milssky/diploma/Презентация/плата.JPG

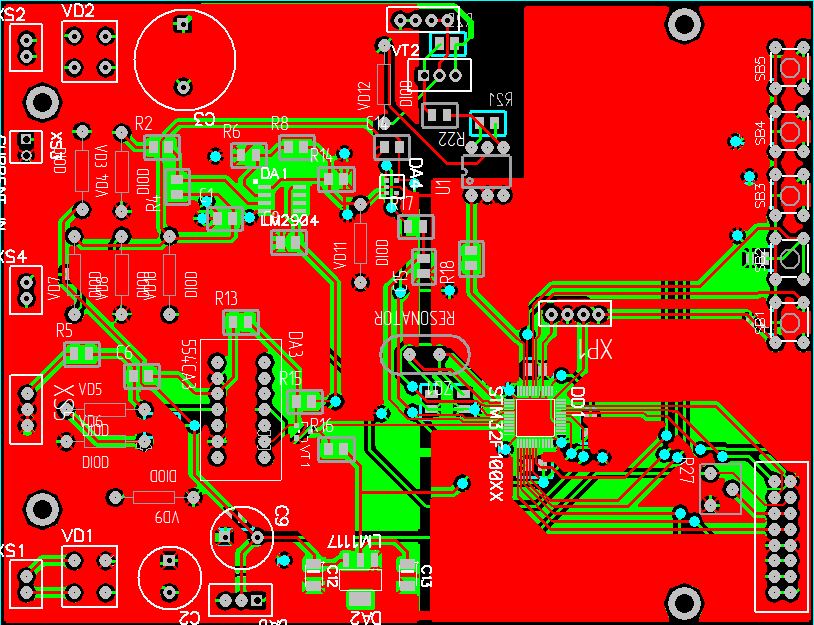
Презентация/плата.JPG
