milssky/diploma/Презентация/фон.jpg

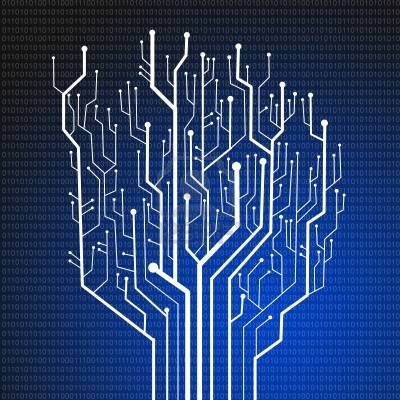
Презентация/фон.jpg
