milssky/diploma/Преддипломная практика/структурная.pdf

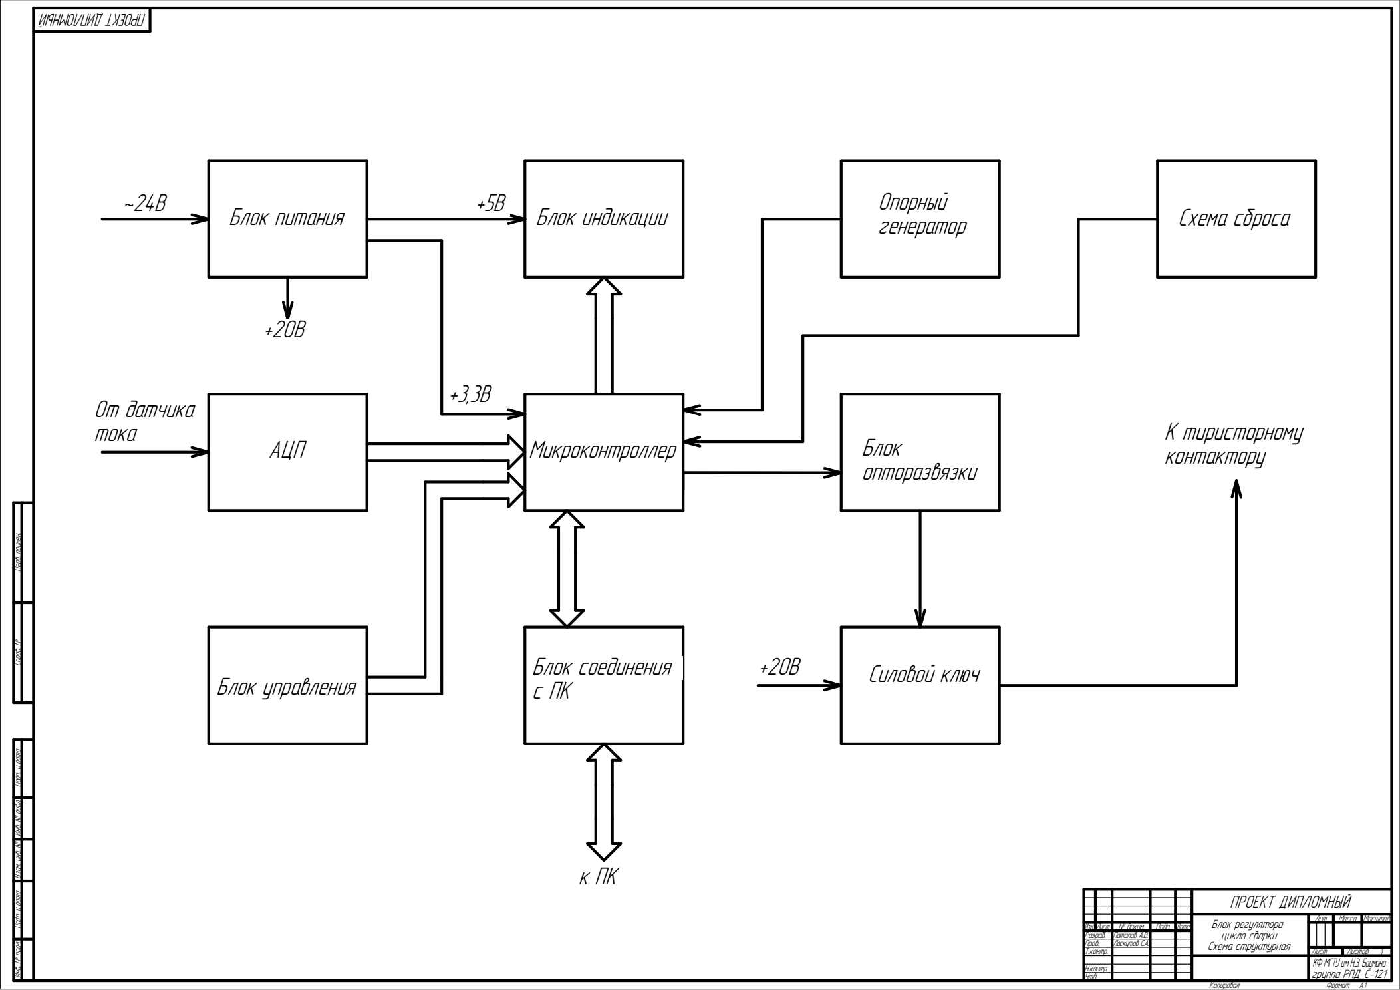
[picture p23: figure]
Ìèêðîêîíòðîëëåð; Áëîê èíäèêàöèè; Áëîê ñîåäèíåíèÿ ñ ÏÊ; ÀÖÏ; Áëîê ïèòàíèÿ; Áëîê óïðàâëåíèÿ; Îïîðíûé ãåíåðàòîð; Áëîê îïòîðàçâÿçêè; Ñèëîâîé êëþ÷; Ñõåìà ñáðîñà; Ê òèðèñòîðíîìó êîíòàêòîðó; +3,3Â Îò äàò÷èêà; òîêà; Èçì.; Ëèñò; ¹ äîêóì.; Ïîäï.; Äàòà; Ðàçðàá.; Ïîòàïîâ À.Â.; Ïðîâ.; Ëîñêóòîâ Ñ.À.; Ò.êîíòð.; Ëèñòîâ 1; Í.êîíòð. Óòâ.; ÏÐÎÅÊÒ ÄÈÏËÎÌÍÛÉ; ÊÔ ÌÃÒÓ èì Í.Ý. Áàóìàíà; Ñïðàâ. ¹ Ïåðâ. ïðèìåí.; Êîïèðîâàë; Ôîðìàò

| | | | | Áëîê ðåãóëÿòîðà öèêëà ñâàðêè Ñõåìà ñòðóêòóðíàÿ | Ëèò. | Ìàññà | Ìàñøòàá

Èíâ. ¹ ïîäë. Ïîäï. è äàòà Âçàì. èíâ. ¹ Èíâ. ¹ äóáë. Ïîäï. è äàòà ãðóïïà ÐÏÄ_Ñ-121
