milssky/diploma/3d/Плата/Сборка блока.png

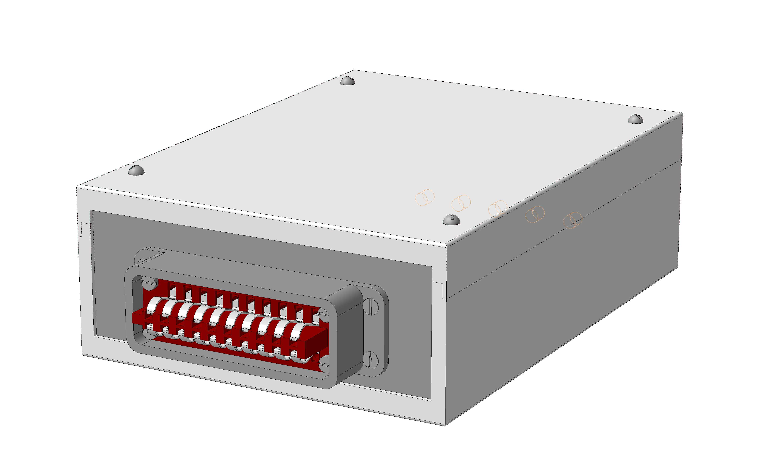
3d/Плата/Сборка блока.png
