milssky/diploma/3d/Сборка блока.jpg

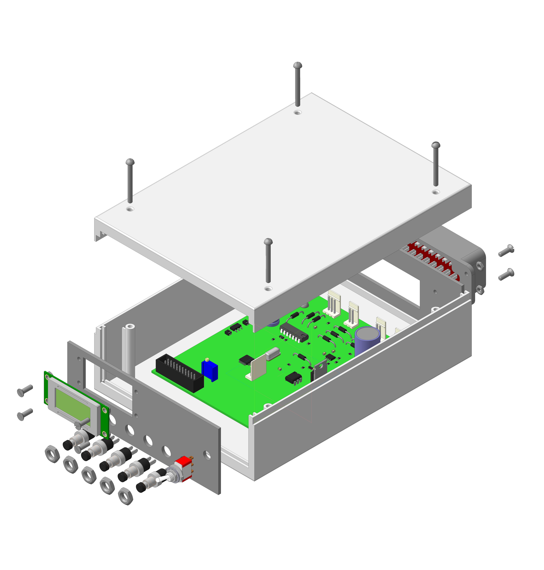
3d/Сборка блока.jpg
