milssky/diploma/3d/Сборка блока.png

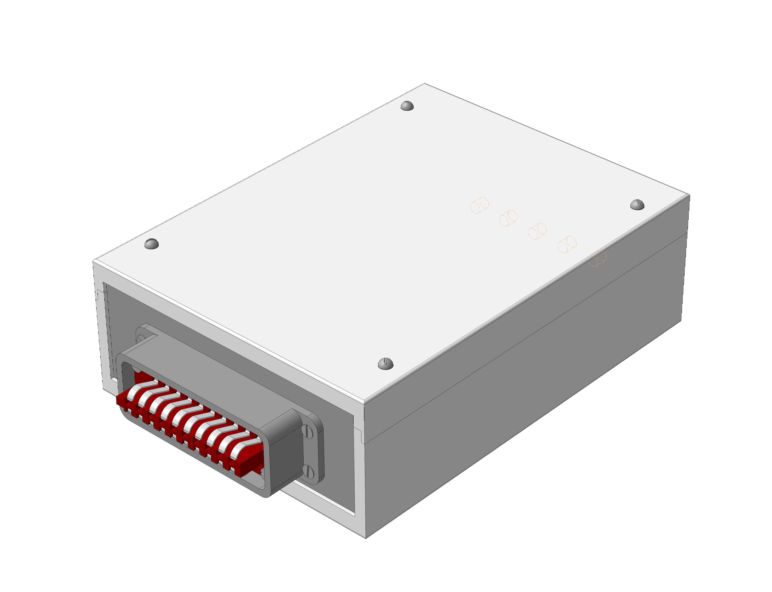
3d/Сборка блока.png
