milssky/diploma/3d/Сборка платы.png

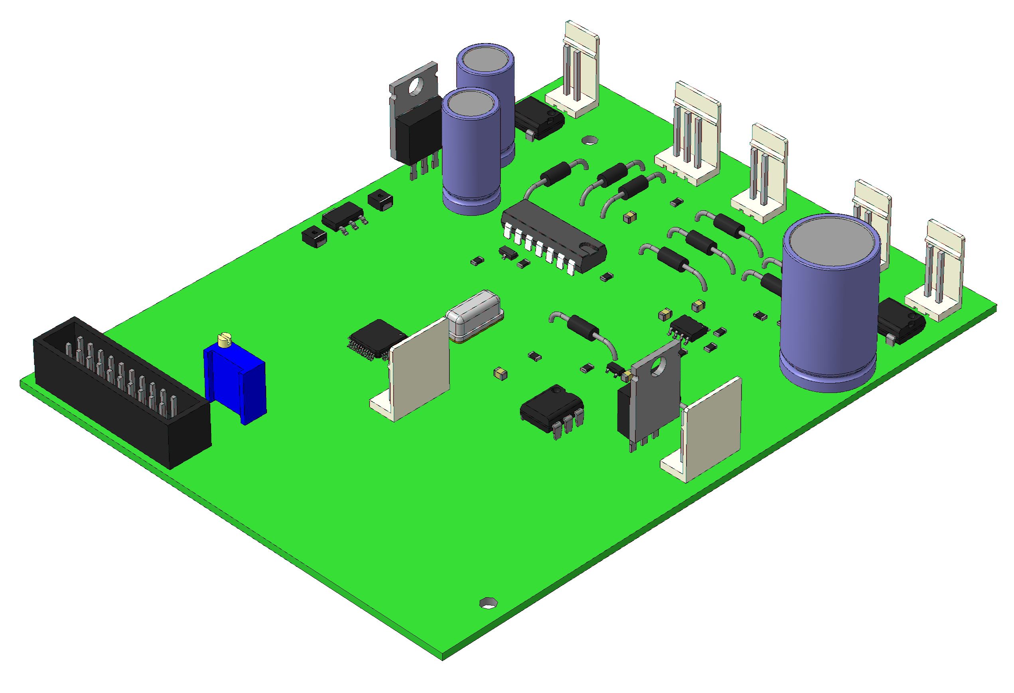
3d/Сборка платы.png
