milssky/diploma/Презентация/bandicam 2013-06-10 00-40-57-685.gif

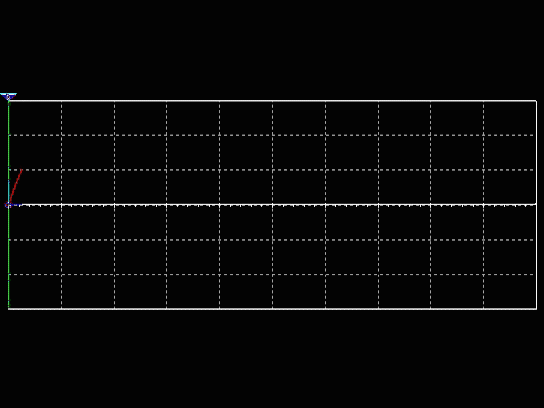
Презентация/bandicam 2013-06-10 00-40-57-685.gif
