milssky/diploma/Презентация/Sequence 01.gif

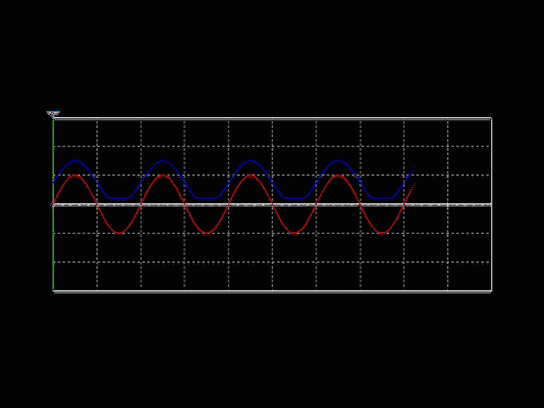
Презентация/Sequence 01.gif
