milssky/diploma/Преддипломная практика/Перечень.xls

Перв. примен. | Поз. обозна- чение |  |  | Наименование |  |  |  |  | Кол. |  | Примечание |  |  | список
 | BQ1 |  |  | Кварцевый резонатор 11.0592 МГц имп. HC-49U |  |  |  |  | 1
 |  |  |  | Чип-конденсаторы GRM216R71 0805 |  |  |  |  |  |  | Murata
 | C1 |  |  | GRM216R71 0805 10 нф, ± 1 % |  |  |  |  | 1
Справ. № | C2,C3 |  |  | GRM216R71 0805 0,1 мк ± 1 % |  |  |  |  | 2
 | C4 |  |  | GRM216R71 0805 22 ± 1 % |  |  |  |  | 1
 | C5 |  |  | GRM216R71 0805 0,1 мк ± 1 % |  |  |  |  | 1
 | C6 |  |  | GRM216R71 0805 22 ± 1 % |  |  |  |  | 1
 | C7 |  |  | GRM216R71 0805 0,1 мк ± 1 % |  |  |  |  | 1
 | C8..C15 |  |  | GRM216R71 0805 1 мк ± 1 % |  |  |  |  | 8
 |  |  |  | Микросхемы
Подп. и дата | DA1 |  |  | Микросхема ADUC812 |  |  |  |  | 1 |  | Analog
 | DD1 |  |  | К555ЛН1 |  |  |  |  | 1
 | DD2 |  |  | К555ЛА3 |  |  |  |  | 1
 | DD3 |  |  | К555АП6 |  |  |  |  | 1
Инв. № дубл. | DD4..DD6 |  |  | К555ЛН1 |  |  |  |  | 3
 |  |  |  | Чип-резисторы 0.125Вт 0805 |  |  |  |  |  |  | Phillips
Взам. инв. № |  |  |  | Резисторы подстроечные 3266W-1-103
 | R1…R8 |  |  | 0.125Вт 0805 2,4k ± 5 % |  |  |  |  | 8
Подп. и дата
 |  |  |  |  |  |  | ПРОЕКТ ДИПЛОМНЫЙ
 | Изм. | Лист | № докум. |  | Подп. | Дата
Инв. № подл. | Разраб. |  | Потапов А.В. |  |  |  | Блок регулятора цикла сварки | Лит. |  | Лист |  | Листов
 | Пров. |  | Лоскутов С.А. |  |  |  |  |  |  | 1 |  | 3
 |  |  |  |  |  |  |  | КФ МГТУ группа РПД_С-81
 | Н. контр.
 | Утв. |  |  |  |  |  | Перечень элементов
 |  |  |  |  |  |  | Копировал: | Формат А4
 | Поз. обозна- чение |  |  | Наименование |  |  |  |  | Кол. |  | Примечание
 | R9 |  |  | 0.125Вт 0805 10k ± 5 % |  |  |  |  | 1
 | R10…R15 |  |  | 0.125Вт 0805 2,4k ± 5 % |  |  |  |  | 6
 | R16 |  |  | 3266W-1-103 10k |  |  |  |  | 1
 | R17…R24 |  |  | 0.125Вт 0805 2,4k ± 5 % |  |  |  |  | 8
 | R25…R32 |  |  | 0.125Вт 0805 1k ± 5 % |  |  |  |  | 8
 | R33 |  |  | 0.125Вт 0805 5,1k ± 5 % |  |  |  |  | 1
 | R34 |  |  | 0.125Вт 0805 15k ± 5 % |  |  |  |  | 1
 | R35 |  |  | 0.125Вт 0805 5,1k ± 5 % |  |  |  |  | 1
 | R36 |  |  | 0.125Вт 0805 15k ± 5 % |  |  |  |  | 1
 | R37 |  |  | 0.125Вт 0805 5,1k ± 5 % |  |  |  |  | 1
 | R38 |  |  | 0.125Вт 0805 15k ± 5 % |  |  |  |  | 1
 | R39 |  |  | 0.125Вт 0805 5,1k ± 5 % |  |  |  |  | 1
 | R40 |  |  | 0.125Вт 0805 15k ± 5 % |  |  |  |  | 1
 | R41 |  |  | 0.125Вт 0805 5,1k ± 5 % |  |  |  |  | 1
Подп. и дата | R42 |  |  | 0.125Вт 0805 15k ± 5 % |  |  |  |  | 1
 | R43 |  |  | 0.125Вт 0805 5,1k ± 5 % |  |  |  |  | 1
 | R44 |  |  | 0.125Вт 0805 15k ± 5 % |  |  |  |  | 1
 | R45 |  |  | 0.125Вт 0805 5,1k ± 5 % |  |  |  |  | 1
Инв. № дубл. | R46 |  |  | 0.125Вт 0805 15k ± 5 % |  |  |  |  | 1
 | R47 |  |  | 0.125Вт 0805 5,1k ± 5 % |  |  |  |  | 1
 | R48 |  |  | 0.125Вт 0805 15k ± 5 % |  |  |  |  | 1
Взам. инв. №
 | U1…U8 |  |  | Оптопара AOT128 |  |  |  |  | 8
Подп. и дата | VD1..VD8 |  |  | Диод 1N4007 |  |  |  |  | 8
 |  |  |  | Вилки
 | XP1 |  |  | WF-6 |  |  |  |  | 1 |  | Zhenqin
Инв. № подл. | XP2 |  |  | WF-2 |  |  |  |  | 1 |  | Zhenqin
 |  |  |  |  |  |  | ПРОЕКТ ДИПЛОМНЫЙ |  |  |  |  |  | Лист
 |  |  |  |  |  |  |  |  |  |  |  |  | 2
 | Изм. | Лист | № докум. |  | Подп. | Дата
 |  |  |  |  |  |  | Копировал: | Формат А4
 | Поз. обозна- чение |  |  | Наименование |  |  |  |  | Кол. |  | Примечание
 | XP3 |  |  | WF-5 |  |  |  |  | 1 |  | Zhenqin
 | XP4 |  |  | WF-14 |  |  |  |  | 1 |  | Zhenqin
 | XP5 |  |  | BH-16 |  |  |  |  | 1 |  | Zhenqin
 | XP6 |  |  | BH-20 |  |  |  |  | 1 |  | Zhenqin
 | XP7 |  |  | WF-18 |  |  |  |  | 1 |  | Zhenqin
Подп. и дата
Инв. № дубл.
Взам. инв. №
Подп. и дата
Инв. № подл.
 |  |  |  |  |  |  | ПРОЕКТ ДИПЛОМНЫЙ |  |  |  |  |  | Лист
 |  |  |  |  |  |  |  |  |  |  |  |  | 3
 | Изм. | Лист | № докум. |  | Подп. | Дата
 |  |  |  |  |  |  | Копировал: | Формат А4
