milssky/diploma/Преддипломная практика/принципиальная.pdf

# 35 DGND 21 DGND 8

# DAC0 10 DAC1 3

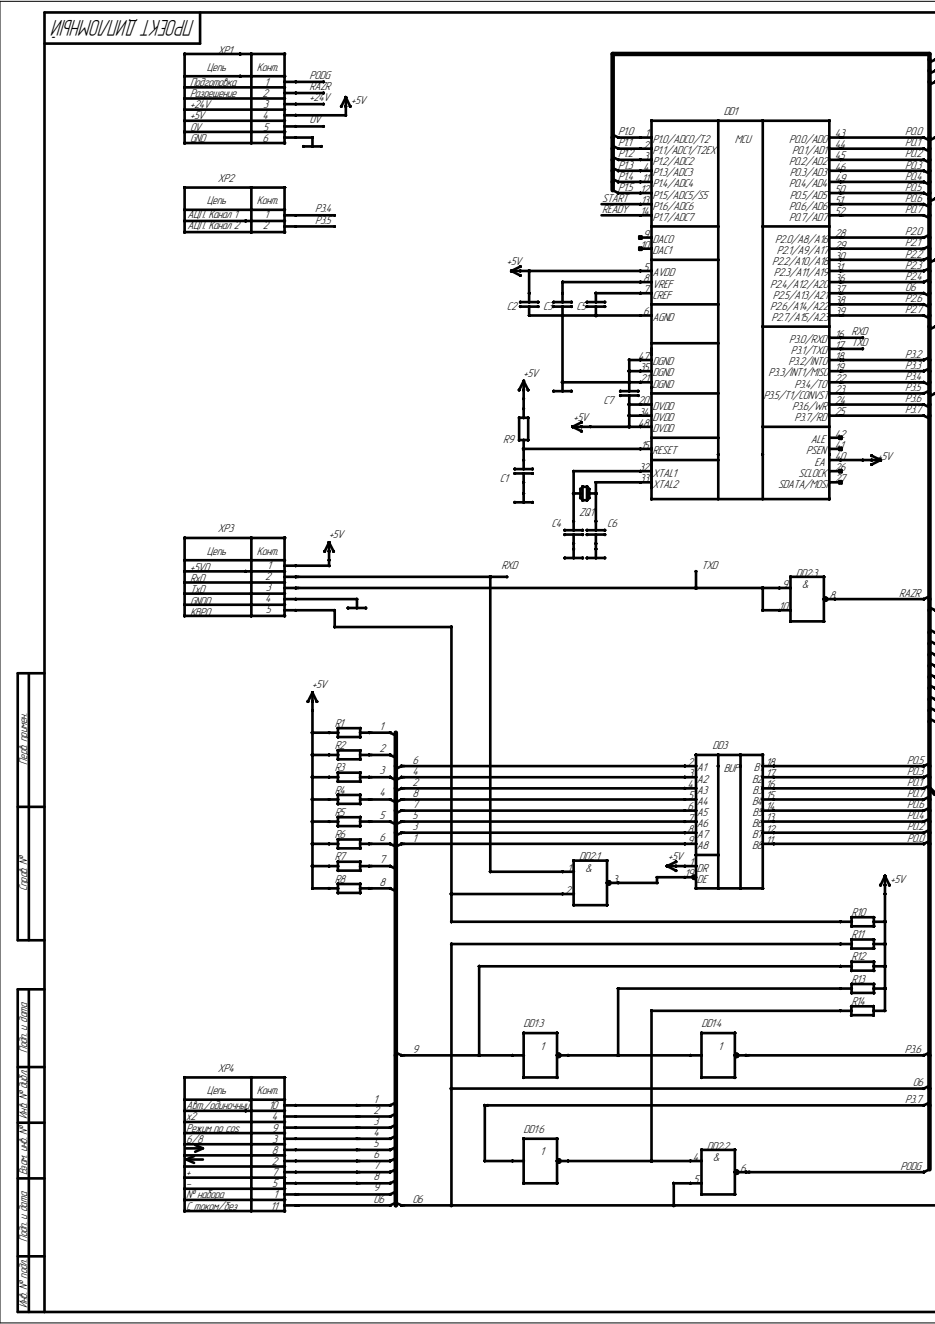
[picture p30: page 1]

Öåïü | Êîíò.
Ïîäãîòîâêà
Ðàçðåøåíèå

ÀÖÏ. Êàíàë 1 ÀÖÏ. Êàíàë 2 | 21

+5VD RxD

TxD
GNDD
KBP0

Èíâ. ¹ ïîäë. Ïîäï. è äàòà Âçàì. èíâ. ¹ Èíâ. ¹ äóáë. Ïîäï. è äàòà Ñïðàâ. ¹ Ïåðâ. ïðèìåí.

Àâò./îäèíî÷íûé õ2

Ðåæèì ïî cos
6/8 -

Ñ òîêîì/áåç +

¹ íàáîðà

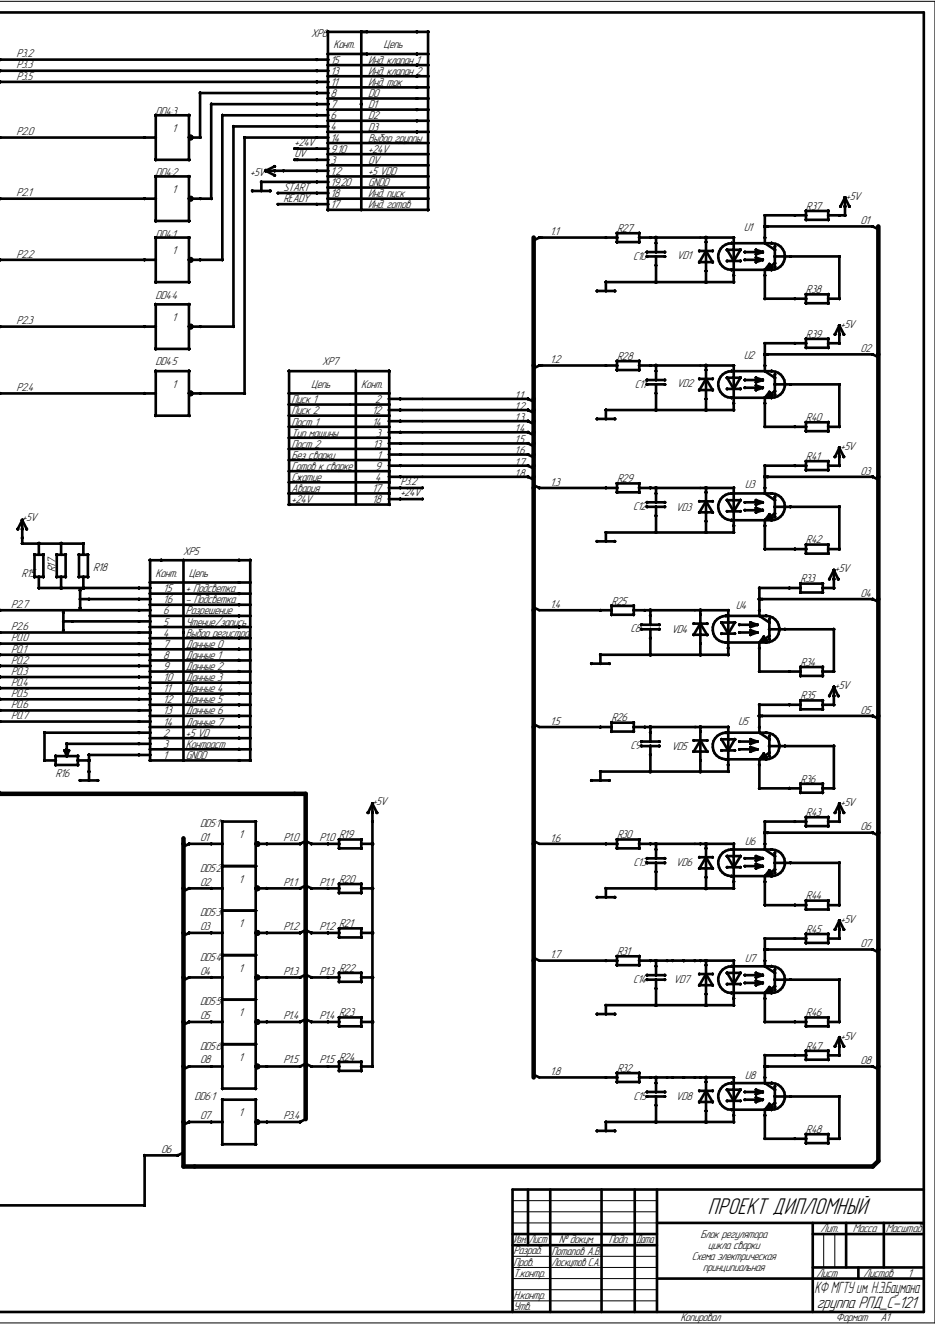
[picture p31: page 2]

Êîíò. | Öåïü
15 | Èíä. êëàïàí 1
13 | Èíä. êëàïàí 2
11 | Èíä. òîê
8 | D0
7 | D1
6 | D2
4 | D3
14 | Âûáîð ãðóïïû
9,10 | +24V
3 | 0V
1,2 | +5 VDD

18 | Èíä. ïóñê
17 | Èíä. ãîòîâ

Öåïü | Êîíò.
Ïóñê 1 Ïóñê 2 | 2

Ïîñò 1 | 14
Òèï ìàøèíû | 3
Ïîñò 2 | 13
Áåç ñâàðêè | 1
Ãîòîâ ê ñâàðêå | 9
Ñæàòèå | 4
Àâàðèÿ | 17
+24V | 18

15 | + Ïîäñâåòêà
16 | - Ïîäñâåòêà
6 | Ðàçðåøåíèå
5 | ×òåíèå/çàïèñü
4 | Âûáîð ðåãèñòðà
7 | Äàííûå 0
8 | Äàííûå 1
9 | Äàííûå 2
10 | Äàííûå 3
11 | Äàííûå 4
12 | Äàííûå 5
13 | Äàííûå 6
14 | Äàííûå 7
2 | +5 VD
3 | Êîíòðàñò
1 | GNDD

ÊÔ ÌÃÒÓ èì. Í.Ý.Áàóìàíà
ãðóïïà ÐÏÄ_C-121
