milssky/diploma/Моделирование/opto_out.CIR

[Main]
FileType=CIR
Version=9.00
Program=Micro-Cap
Screen=1600,900
MCAPVersion=9.0.6.1
Key ID=2 233 293 684
NLCnt=42
TXCnt=5

[shapedef]
Name=Battery
Line=0,0,22,0
Line=22,-3,22,3
Line=26,-7,26,7
Line=26,0,48,0
Current=32,8,16,8

[shapedef]
Name=Pulse_Source
Root="Vsource.root",0,-12,0
Line=20,-4,20,0
Line=20,0,26,0
Line=26,0,26,4

[shapedef]
Name=Resistor
PolyOpen=12 
PolyLine=0,0
PolyLine=0,0
PolyLine=12,0
PolyLine=14,-4
PolyLine=18,4
PolyLine=22,-4
PolyLine=26,4
PolyLine=30,-4
PolyLine=34,4
PolyLine=36,0
PolyLine=48,0
PolyLine=48,0
Current=32,8,16,8

[shapedef]
Name=Diode
Root="Diode.root",0,-8,0

[shapedef]
Name=NPN
Root="Bjt.root",0,-24,0
PolyClosed=3 ,Solid
PolyLine=20,12
PolyLine=24,12
PolyLine=24,8

[shapedef]
Name=Ground
Line=0,0,12,0
Line=12,-8,12,8
Line=18,-4,18,4
Line=24,0,24,0

[shapedef]
Name=Diode.root
Line=0,0,20,0
Line=28,0,48,0
Rectangle=18,-8,20,8,SOLID
PolyClosed=3 ,Solid
PolyLine=20,0
PolyLine=28,-8
PolyLine=28,8
Current=32,16,16,16

[shapedef]
Name=Vsource.root
Line=0,0,12,0
Line=36,0,48,0
Ellipse=12,-12,36,12
Line=7,5,7,9
Root="Plus.root",39,5,0
Current=32,16,16,16

[shapedef]
Name=Plus.root
Line=-2,0,2,0
Line=0,-2,0,2

[shapedef]
Name=Bjt.root
Line=0,0,13,0
Rectangle=13,-12,15,12,SOLID
Current=32,-24,32,-16
Current=32,24,32,16
Current=0,-8,8,-8
PolyOpen=3 
PolyLine=24,-24
PolyLine=24,-12
PolyLine=14,-2
PolyOpen=3 
PolyLine=24,24
PolyLine=24,12
PolyLine=14,2

[shapedef]
Name=Optocoupler_Dar
Rectangle=0,-16,64,80
Rectangle=16,16,16,24
Line=0,-8,12,-8
PolyClosed=3 ,Solid
PolyLine=4,8
PolyLine=20,8
PolyLine=12,16
Line=12,-8,12,8
Line=20,16,4,16
Line=12,16,12,32
Line=12,32,0,32
Line=0,-8,-16,-8
Line=0,32,-16,32
Line=28,-8,80,-8
Line=64,32,80,32
Line=64,72,80,72
Line=64,72,56,72
Line=64,32,56,32
Line=56,32,56,40
Line=56,72,56,64
Line=56,40,48,48
Line=56,64,48,56
PolyClosed=3 ,Solid
PolyLine=54,58
PolyLine=50,62
PolyLine=54,62
Rectangle=46,44,48,60,SOLID
Line=46,52,40,52
Line=40,32,56,32
Line=40,32,34,38
Line=40,52,34,46
PolyClosed=3 ,Solid
PolyLine=39,47
PolyLine=35,51
PolyLine=39,51
Rectangle=32,34,34,50,SOLID
Line=32,42,28,42
Line=28,42,28,-8
PolyClosed=3 ,Solid
PolyLine=24,38
PolyLine=20,42
PolyLine=24,42
PolyOpen=6 
PolyLine=22,40
PolyLine=20,36
PolyLine=18,40
PolyLine=16,36
PolyLine=14,40
PolyLine=12,36

[compdef]
Name=4N33_MC
Definition=Subckt
Shape=Optocoupler_Dar
Mask=4224
memo=Photodarlington Optocoupler Vr=3V Vceo=30V Ic=150mA
Label Offset=19,81,19,15
PinCnt=5
Pin="4",a,-2,-1,-2,-2
Pin="5",a,-2,4,-2,-2
Pin="3",a,10,9,-2,-2
Pin="1",a,10,4,-2,-2
Pin="2",a,10,-1,-2,-2

[compdef]
Name=Resistor
Definition=Resistor
Shape=Resistor
Mask=7681
memo=Resistor
Label Offset=18,6,8,11
PinCnt=2
Pin="Plus",6,0,-10,-4
Pin="Minus",0,0,-14,-4

[compdef]
Name=Ground
Definition=Ground
Shape=Ground
Mask=257
memo=Ground
Label Offset=0,0,0,0
PinCnt=1
Pin="PinA",0,0,-3,-7

[compdef]
Name=Battery
Definition=Battery
Shape=Battery
Mask=4865
memo=Battery
Label Offset=19,7,10,13
PinCnt=2
Pin="Plus",6,0,-4,-5
Pin="Minus",0,0,-10,-5

[compdef]
Name=BCV27_PH
Definition=Subckt
Shape=NPN
Mask=4224
memo=NPN Darlington transistor
Label Offset=29,-14,-6,25
PinCnt=3
Pin="2",a,0,0,-2,-3
Pin="3",a,3,3,6,7
Pin="1",a,3,-3,5,6

[compdef]
Name=Diode
Definition=Diode
Shape=Diode
Mask=4609
memo=Diode
Label Offset=17,10,12,12
PinCnt=2
Pin="Anode",6,0,-9,-8
Pin="Cathode",0,0,-20,-8

[compdef]
Name=Pulse Source
Definition=Pulse source
Shape=Pulse_Source
Mask=4865
memo=Pulse Source
Label Offset=18,13,15,9
PinCnt=2
Pin="Plus",6,0,-5,-4
Pin="Minus",0,0,-19,-4

[Circuit]
Window Placement=2,3, -1,-1, -8,-30, 0,0,1130,522
Default Object=Color=#000080
Default Object Font=Height=-15,FStyle=0,Color=#000080,Name=Arial
Default Object Apply Border To Text=No
Default Object Apply Fill To Text=No
WinBackGround Color=#FFFFFF
Select Color=#FF0000
Select Box Color=#000080
Grid Text Color=Height=-12,FStyle=0,Color=#800000,Name=Arial
Component Color=#0000FF
Attribute Text=Height=-12,FStyle=0,Color=#008000,Name=Arial
Wire Color=#008000
Bus Color=#008000
Pin Connection=Height=-10,FStyle=0,Color=#FF0000,Name=Arial
Node Number=Height=-11,FStyle=0,Color=#FF00FF,Name=Arial
Node Voltage Color=#000000
Dynamic AC Voltage Color=#E4E4E4
Text Banner Text=Height=-15,FStyle=0,Color=#800000,Name=Arial
Title Block Background=#C0C0C0
Current=Height=-11,FStyle=0,Color=#0000FF,Name=Arial
Power/Condition=Height=-11,FStyle=0,Color=#FF0000,Name=Arial
Digital Path Color=#FF0000
Title Block=Height=-15,FStyle=0,Color=#000000,Name=Arial
Disabled	Color=#C0C0C0
KeyWord Color=#0000FF
Error	Color=#FF0000
Digital 0 Color=#000000
Digital R Color=#FFFF00
Digital F Color=#FFFF00
Digital 1 Color=#FF0000
Digital X Color=#C0C0C0
Digital Z Color=#808080
Window Placement in Transient Analysis=2,3, -1,-1, -8,-30, 0,0,1130,522
SpiceType=AMBIGUOUS
Block Select Color=#51F998
TitleBlock Field_1=$name
TitleBlock Field_2=$user $company
TitleBlock Field_3
TitleBlock Field_4=$date
TitleBlock Field_5=Page $page of $maxpage
TitleBlock One Title=False
Title_Block_Border=False
Title_Block=False
Show Nodes=True
Show Voltages=False
Show Current=False
Show Power=False
Show Condition=False
Show Pin Connections=False
Show Cross=False
Show Attribute Text=True
Show Grid Text=True

[Comp]
Name=4N33_MC
Grid=52,37

[Attr]
ONV=19,81,PART,X1
Style=8192

[Attr]
ONV=19,93,NAME,4N33_MC

[Attr]
ONV=19,117,PACKAGE,MOT730A-04

[Comp]
Name=Resistor
Grid=44,36
Rot=6

[Attr]
ONV=-32,6,PART,R1
Style=8192

[Attr]
ONV=-36,18,RESISTANCE,100
Style=8192

[Wire]
Grids=32,36,38,36

[Wire]
Grids=32,36,32,37

[Wire]
Grids=44,36,50,36

[Comp]
Name=Ground
Grid=47,41
Rot=1

[Comp]
Name=Ground
Grid=32,43
Rot=1

[Wire]
Grids=47,41,50,41

[Comp]
Name=Battery
Grid=18,39
Rot=3

[Attr]
ONV=-24,-25,PART,V2
Style=8192

[Attr]
ONV=-22,-37,VALUE,24

[Wire]
Grids=18,39,18,40

[Wire]
Grids=18,30,18,32

[Wire]
Grids=18,40,18,41

[Wire]
Grids=18,32,18,33

[Wire]
Grids=62,41,64,41

[Wire]
Grids=64,41,65,41

[Wire]
Grids=62,36,70,36

[Wire]
Grids=70,36,70,39

[Comp]
Name=Resistor
Grid=70,39
Rot=7

[Attr]
ONV=10,6,PART,R2
Style=8192

[Attr]
ONV=4,22,RESISTANCE,100k
Style=8192

[Wire]
Grids=62,46,70,46

[Wire]
Grids=70,45,70,46

[Wire]
Grids=70,46,72,46

[Comp]
Name=Resistor
Grid=78,46
Rot=6

[Attr]
ONV=-32,6,PART,R3
Style=8192

[Attr]
ONV=-38,18,RESISTANCE,1.5k
Style=8192

[Comp]
Name=Resistor
Grid=83,47
Rot=7

[Attr]
ONV=-32,6,PART,R4
Style=8192

[Attr]
ONV=-36,18,RESISTANCE,10k
Style=8192

[Wire]
Grids=78,46,83,46

[Wire]
Grids=83,46,83,47

[Wire]
Grids=83,53,83,54

[Comp]
Name=BCV27_PH
Grid=87,46

[Attr]
ONV=29,-14,PART,X2
Style=8192

[Attr]
ONV=29,-2,NAME,BCV27_PH

[Attr]
ONV=29,22,PACKAGE,SOT-23

[Wire]
Grids=83,46,87,46

[Wire]
Grids=83,54,87,54

[Wire]
Grids=90,49,90,54

[Wire]
Grids=87,54,87,56

[Wire]
Grids=87,54,90,54

[Comp]
Name=Diode
Grid=90,36
Rot=1

[Attr]
ONV=-31,-22,PART,D1
Style=8192

[Attr]
ONV=-55,-34,MODEL,1N4148

[Attr]
ONV=-51,-58,PACKAGE,DO-35

[Wire]
Grids=90,42,90,43

[Wire]
Grids=90,32,90,35

[Wire]
Grids=90,42,92,42

[Wire]
Grids=90,35,90,36

[Comp]
Name=Pulse Source
Grid=32,43
Rot=3

[Attr]
ONV=-29,-21,PART,V3
Style=8192

[Attr]
ONV=-70,-33,MODEL,SQUARE

[Wire]
Grids=70,46,70,46

[Wire]
Grids=83,46,83,46

[Wire]
Grids=70,46,70,46

[Wire]
Grids=83,46,83,46

[Grid Text]
Text="0v"
Grid=18,40
CBorder=NONE

[Grid Text]
Text="24v"
Grid=18,32
CBorder=NONE

[Grid Text]
Text="24v"
Grid=64,41
CBorder=NONE

[Grid Text]
Text="0v"
Grid=87,56
CBorder=NONE

[Grid Text]
Text="24v"
Grid=90,35
CBorder=NONE

[Schematic]
CurrentSection 0=0
CurrentSection 1=0
CurrentSection 2=0
CurrentSection 3=0
Splitter.xs=0
Splitter.ys=0
TextQuad=4099
Scale=0.5
PrinterScale=1
GridUser=10
ShapeGroups="Main","DeMorgan","Main1","Euro","Rus","Polarity","Main11","Main2","Electrolytic"
CalcRMS=False
CalcAVG=False
CalcPeak=False
DisplayMeasure=Last

[Tools]
Pos=Top
PROBE=Yes
SELECT=Yes
COMP=Yes
TEXT=Yes
WIRE=Yes
WIRED=Yes
BUS=Yes
GRAPHIC=Yes
LINE=No
ELLIPSE=No
RECT=No
DIAM=No
ARC=No
PIE=No
LEFTBRK=No
RIGHTBRK=No
BOTHBRK=No
FLAG=Yes
META=No
INFO=Yes
HELP=Yes
LINK=Yes
REGION_ENABLE=Yes
DIGTRC=No
DIGTRC2=No
DIGALL=No
GRIDTEXT=Yes
COMPTEXT=Yes
NODE=Yes
MEASURED=Yes
NODEV=Yes
CURRENT=Yes
POWER=Yes
CONDITIN=Yes
PIN=Yes
CROSS=Yes
GRID=Yes
BORDER=Yes
TITLE=Yes
RUBBER=Yes
PROPERTY=Yes
STEP=Yes
MIRROR=Yes
ROTATE=Yes
FLIPY=Yes
FLIPX=Yes
FINDCOMP=Yes
FIND=Yes
REPEAT=No
MODEL=Yes
CIR2CKT=No
ATTDISP=No
ENABLE=Yes
DISABLE=Yes
TOFRONT=Yes
TOBACK=Yes
SELNEXT=No
PAGEADD=Yes
PAGEDEL=Yes
ZOOMIN=Yes
ZOOMOUT=Yes
GOTOFLAG=Yes
UPLEVEL=Yes
COLOR=Yes
FONT=Yes

[Section]
Index=0
Name="circuit1"
Type=Main
Enable=True
CurrentPage 0=0
CurrentPage 1=0
CurrentPage 2=0
CurrentPage 3=0
TabSize 0=425
TabSize 1=425
TabSize 2=425
TabSize 3=425

[Page]
Index=0
Section=0
Print=True
Enable=True
Name=Main
Scale 0=1
Scale 1=1
Scale 2=1
SB 3=91,211
Scale 3=0.5
Grid=73,56

[Page]
Index=1
Section=0
Type=Text
Print=False
Enable=True
Name=Text

[Page]
Index=2
Section=0
Type=Text
Print=False
Enable=True
Name=Models
SB 0=0,2

[Page]
Index=3
Section=0
Type=Info
Print=False
Enable=True
Name=Info

[Text Area]
Section=0
Page=1
Font=Height=-15,FStyle=0,Color=#000080,Name=Courier New
Comment Color=#808080
Background Color=#FFFFFF
Len=0


[Text Area]
Section=0
Page=2
Font=Height=-15,FStyle=0,Color=#000080,Name=Courier New
Comment Color=#808080
Background Color=#FFFFFF
Len=239
*** From file C:\MC9\library\UTILITY.LBR
*** 5V Pulse Source
.MODEL PULSE PUL (P1=100u P2=101u P3=102u P4=103u P5=104u)
*** From file C:\MC9\library\UTILITY.LBR
*** 5V Square Wave
.MODEL SQUARE PUL (P1=0 P2=1u P3=500u P4=501u P5=502u)

[Transient]
Window Placement=2,3, -1,-1, -8,-30, 0,0,1130,522
Font=Height=-15,FStyle=0,Color=#0000FF,Name=Arial
WinBackGround Color=#FFFFFF
Select Color=#FF0000
Select Box Color=#000080
Title
AutoTitle=Yes
Grid Color=#808080
Grid Weight=1
Grid Pattern=Dot6
Tracker Foreground=Height=-15,FStyle=0,Color=#000000,Name=Arial
Tracker Background=#FFFF00
Baseline color=#0000FF
Static Grids=False
PlusMark=False
MinorLog25=Off
LabelMinor=Off
OperPoint=True
OperPointOnly=False
AutoScaleRanges=True
DataPoints=False
Token=False
Ruler=False
XAxisGrids=True
YAxisGrids=True
MinorLogGrids=True
BaseLine=False
Graph Background=#FFFFFF
Tracker Intercept=False
Tracker Mouse=True
Tracker Cursor=True
Tracker Cursor BranchInfo=False
Horizontal Cursor=False
Same Y Scales=Yes
Enable X Scaling=True
Enable Y Scaling=True
Keep X Scales The Same=False
Number of Grids X=5
Number of Grids Y=5
Cursor Select Color Primary=#C0C0C0
Cursor Select Color Secondary=#FF0000
Data Point Labels Color Fore=Height=-15,FStyle=0,Color=#000000,Name=Arial
Data Point Labels Color Back=#FFFF00
FFT_NPts="1024"
FFT_IncludeDCHarmonic=False
FFT_AutoScale_Harmonics="10"
PrinterAutoTile=No
PrinterBlackBorder=No
MonMaxShow=3
MonPageWidth=66
MonPlotWidth=21
MonExprXWidth=142
MonExprYWidth=260
MonRangeXWidth=90
MonRangeYWidth=90
AnimateWait=0
AnimateWaitTime=500
Save_For_Future=No
Reduce_Display=1
Reduce_Save=1
Num Out Header Left
Num Out Header Center="$MC\n$user\n$company\n$Analysis of $name"
Num Out Header Right
Num Out Delimiter=32
Num Out Write=True
Num Out Write Main Header=True
Num Out Write Limits=True
Num Out Write Branch Header=True
Num Out Write Models=True
Num Out Write Zero Models=True
Num Out Write Undefined Models=True
Num Out Write Operating Point=True
Num Out Write Values=True
Num Out Write Waveform Header=True
Num Out Low="TMIN"
Num Out High="TMAX"
Num Out Font=Height=-15,FStyle=0,Color=#000080,Name=Courier New

[Tools]
Pos=Top
SELECT=Yes
GRAPHIC=Yes
LINE=No
ELLIPSE=No
RECT=No
DIAM=No
ARC=No
PIE=No
LEFTBRK=No
RIGHTBRK=No
BOTHBRK=No
POLYCLOS=No
SCALE=Yes
CURSOR=Yes
MEASUREH=Yes
MEASUREV=Yes
TAG=Yes
PTAG=Yes
TEXT=Yes
PROPERTY=Yes
START=Yes
STOP=Yes
PAUSE=Yes
DATAPTS=Yes
TOKENS=Yes
RULER=Yes
PLUS=Yes
XAXIS=Yes
YAXIS=Yes
MINORLOG=Yes
LOG25=Yes
BASELINE=Yes
HORIZCUR=Yes
GOTOX=Yes
GOTOY=Yes
GOTOPERF=Yes
GOTOBRNC=Yes
CLEAR_ACCUMULATED=Yes
PDELETE_ALL_PLOTS=Yes
NEXT=Yes
NEXTIN=Yes
PEAK=Yes
VALLEY=Yes
HIGH=Yes
LOW=Yes
INFLECTN=Yes
GHIGH=Yes
GLOW=Yes
BOTTOM=Yes
TOP=Yes
WAVEFORMBUFFER=Yes
AOUTPUT=Yes
PKEY=Yes
ENXSCALE=Yes
ENYSCALE=Yes
ZOOMIN=Yes
ZOOMOUT=Yes
AUTOSCALE=Yes
COLOR=Yes
FONT=Yes
SELNEXT=No

[APage]
Analysis=Transient
Name="Main"

[Monte Carlo Options]
Analysis=Transient
Status=Off
Zero Tolerance=False
Distribution=Normal
Number of Runs=10
Seed=0

[Limits]
Analysis=Transient
TRange=50m
TStep=0.001
NPts=51
Temp=27
RetraceRuns=1
StateVar=Zero
RunOption=Normal
Temperature Type=Linear
Accumulate Plots=False

[WaveForm]
Analysis=Transient
Plt=1
AliasID=1
XExp=T
YExp=v(5)
XRng=0.03
YRng=7.5e6
Options=LINEARX,LINEARY
Range Grid X=0.006
Range Grid Y=1.5e6
Line Color=#0000FF
Text Color=#0000FF
Rainbow=False
VFmtX=3
VFmtY=3
ScaleFactorX="None"
ScaleFactorY="None"
ScaleUnitsX="Auto"
ScaleUnitsY="Auto"
SFmtX=3
SFmtY=3

[WaveForm]
Analysis=Transient
Plt=1
AliasID=2
XExp=T
YExp=v(8)
XRng=0.03
YRng=7.5e6
Options=LINEARX,LINEARY
Range Grid X=0.006
Range Grid Y=1.5e6
Line Color=#FF0000
Text Color=#FF0000
Rainbow=False
VFmtX=3
VFmtY=3
ScaleFactorX="None"
ScaleFactorY="None"
ScaleUnitsX="Auto"
ScaleUnitsY="Auto"
SFmtX=3
SFmtY=3

[WaveForm]
Analysis=Transient
Plt=1
AliasID=3
XExp=T
YExp=v(2)
XRng=0.03
YRng=7.5e6
Options=LINEARX,LINEARY
Range Grid X=0.006
Range Grid Y=1.5e6
Line Color=#008000
Text Color=#008000
Rainbow=False
VFmtX=3
VFmtY=3
ScaleFactorX="None"
ScaleFactorY="None"
ScaleUnitsX="Auto"
ScaleUnitsY="Auto"
SFmtX=3
SFmtY=3

[Limits]
Analysis=DynamicAC
FirstValueDisplay=Mag
SecondValueDisplay=PhaseDeg
PlaceText=True

[Limits]
Analysis=DynamicDC
PlaceText=True

[Pane]
Analysis=Transient
CurrentPage 0="Main"

[Pane]
Analysis=AC

[Pane]
Analysis=DC

[Pane]
Analysis=Distortion

[Watch]
Analysis=Transient
Format=3
ExprPercentWidth=80

[OPMethods]
Analysis=Transient
Standard Newton-Raphson=0,0
Source Stepping=0,0
Diagonal Gmin Stepping=0,0
Junction Gmin Stepping=0,0
Pseudo Transient=0,0

[OPMethods]
Analysis=AC
Standard Newton-Raphson=0,0
Source Stepping=0,0
Diagonal Gmin Stepping=0,0
Junction Gmin Stepping=0,0
Pseudo Transient=0,0

[OPMethods]
Analysis=DC
Standard Newton-Raphson=0,0
Source Stepping=0,0
Diagonal Gmin Stepping=0,0
Junction Gmin Stepping=0,0
Pseudo Transient=0,0
