milssky/diploma/Моделирование/comprator.CIR

[Main]
FileType=CIR
Version=9.00
Program=Micro-Cap
Screen=1600,900
MCAPVersion=9.0.6.1
Key ID=2 233 293 684
NLCnt=64
TXCnt=7

[shapedef]
Name=Battery
Line=0,0,22,0
Line=22,-3,22,3
Line=26,-7,26,7
Line=26,0,48,0
Current=32,8,16,8

[shapedef]
Name=Sine_Source
Root="Vsource.root",0,-12,0
Line=24,-6,26,-4
Line=26,-4,26,-2
Line=26,-2,22,2
Line=22,2,22,4
Line=22,4,24,6

[shapedef]
Name=Resistor
PolyOpen=12 
PolyLine=0,0
PolyLine=0,0
PolyLine=12,0
PolyLine=14,-4
PolyLine=18,4
PolyLine=22,-4
PolyLine=26,4
PolyLine=30,-4
PolyLine=34,4
PolyLine=36,0
PolyLine=48,0
PolyLine=48,0
Current=32,8,16,8

[shapedef]
Name=Capacitor
Line=0,0,22,0
Line=22,-8,22,8
Line=26,-8,26,8
Line=26,0,48,0
Current=32,12,16,12

[shapedef]
Name=Diode
Root="Diode.root",0,-8,0

[shapedef]
Name=NPN
Root="Bjt.root",0,-24,0
PolyClosed=3 ,Solid
PolyLine=20,12
PolyLine=24,12
PolyLine=24,8

[shapedef]
Name=Ground
Line=0,0,12,0
Line=12,-8,12,8
Line=18,-4,18,4
Line=24,0,24,0

[shapedef]
Name=Diode.root
Line=0,0,20,0
Line=28,0,48,0
Rectangle=18,-8,20,8,SOLID
PolyClosed=3 ,Solid
PolyLine=20,0
PolyLine=28,-8
PolyLine=28,8
Current=32,16,16,16

[shapedef]
Name=Opamp.root
Line=0,48,6,48
Line=0,0,5,0
Line=6,-4,6,52
Line=6,-4,48,24
Line=6,52,48,24
Line=48,24,72,24
Line=10,12,14,12
Line=12,10,12,14
Line=10,36,14,36
Line=4,0,6,0

[shapedef]
Name=Minus.root
Line=-2,0,2,0

[shapedef]
Name=Vsource.root
Line=0,0,12,0
Line=36,0,48,0
Ellipse=12,-12,36,12
Line=7,5,7,9
Root="Plus.root",39,5,0
Current=32,16,16,16

[shapedef]
Name=Plus.root
Line=-2,0,2,0
Line=0,-2,0,2

[shapedef]
Name=Bjt.root
Line=0,0,13,0
Rectangle=13,-12,15,12,SOLID
Current=32,-24,32,-16
Current=32,24,32,16
Current=0,-8,8,-8
PolyOpen=3 
PolyLine=24,-24
PolyLine=24,-12
PolyLine=14,-2
PolyOpen=3 
PolyLine=24,24
PolyLine=24,12
PolyLine=14,2

[shapedef]
Name=Comp6
Root="Plus.root",7,-14,0
Root="Minus.root",7,44,0
Line=16,48,16,26
Line=16,-16,16,5
Line=24,21,24,40
Line=24,40,56,40
Root="Opamp.root",-16,-12,0

[compdef]
Name=k544ca3
Definition=Subckt
Shape=Comp6
Mask=4096
Label Offset=0,0,-23,193
PinCnt=6
Pin="1",a,-2,-1
Pin="2",a,-2,5
Pin="3",a,2,-2
Pin="4",a,2,6
Pin="5",a,7,2
Pin="6",a,7,5

[compdef]
Name=Diode
Definition=Diode
Shape=Diode
Mask=4609
memo=Diode
Label Offset=17,10,12,12
PinCnt=2
Pin="Anode",6,0,-9,-8
Pin="Cathode",0,0,-20,-8

[compdef]
Name=Resistor
Definition=Resistor
Shape=Resistor
Mask=7681
memo=Resistor
Label Offset=18,6,8,11
PinCnt=2
Pin="Plus",6,0,-10,-4
Pin="Minus",0,0,-14,-4

[compdef]
Name=Ground
Definition=Ground
Shape=Ground
Mask=257
memo=Ground
Label Offset=0,0,0,0
PinCnt=1
Pin="PinA",0,0,-3,-7

[compdef]
Name=Battery
Definition=Battery
Shape=Battery
Mask=4865
memo=Battery
Label Offset=19,7,10,13
PinCnt=2
Pin="Plus",6,0,-4,-5
Pin="Minus",0,0,-10,-5

[compdef]
Name=Sine Source
Definition=Sine source
Shape=Sine_Source
Mask=5121
memo=Sine Source
Label Offset=18,12,15,12
PinCnt=2
Pin="Plus",6,0,-6,-6
Pin="Minus",0,0,-19,-6

[compdef]
Name=Capacitor
Definition=Capacitor
Shape=Capacitor
Mask=7681
memo=Capacitor
Label Offset=16,12,12,12
PinCnt=2
Pin="Plus",6,0,-3,-5
Pin="Minus",0,0,-14,-5

[compdef]
Name=BC847
Definition=NPN
Shape=NPN
Mask=4224
memo=NPN General Purpose Transistor 45V .1A .25W
Label Offset=29,-11,-6,26
PinCnt=3
Pin="Collector",3,-3,5,3
Pin="Base",0,0,-19,-3
Pin="Emitter",3,3,6,4
Power=0.25

[Circuit]
Window Placement=2,3, -1,-1, -8,-30, 0,0,1130,522
Default Object=Color=#000080
Default Object Font=Height=-15,FStyle=0,Color=#000080,Name=Arial
Default Object Apply Border To Text=No
Default Object Apply Fill To Text=No
WinBackGround Color=#FFFFFF
Select Color=#FF0000
Select Box Color=#000080
Grid Text Color=Height=-12,FStyle=0,Color=#800000,Name=Arial
Component Color=#0000FF
Attribute Text=Height=-12,FStyle=0,Color=#008000,Name=Arial
Wire Color=#008000
Bus Color=#008000
Pin Connection=Height=-10,FStyle=0,Color=#FF0000,Name=Arial
Node Number=Height=-11,FStyle=0,Color=#FF00FF,Name=Arial
Node Voltage Color=#000000
Dynamic AC Voltage Color=#E4E4E4
Text Banner Text=Height=-15,FStyle=0,Color=#800000,Name=Arial
Title Block Background=#C0C0C0
Current=Height=-11,FStyle=0,Color=#0000FF,Name=Arial
Power/Condition=Height=-11,FStyle=0,Color=#FF0000,Name=Arial
Digital Path Color=#FF0000
Title Block=Height=-15,FStyle=0,Color=#000000,Name=Arial
Disabled	Color=#C0C0C0
KeyWord Color=#0000FF
Error	Color=#FF0000
Digital 0 Color=#000000
Digital R Color=#FFFF00
Digital F Color=#FFFF00
Digital 1 Color=#FF0000
Digital X Color=#C0C0C0
Digital Z Color=#808080
Window Placement in Transient Analysis=2,3, 0,749, -8,-30, 25,25,1375,551
Window Placement in AC Analysis=2,3, -1,-1, -8,-30, 175,175,1525,701
SpiceType=AMBIGUOUS
Block Select Color=#51F998
TitleBlock Field_1=$name
TitleBlock Field_2=$user $company
TitleBlock Field_3
TitleBlock Field_4=$date
TitleBlock Field_5=Page $page of $maxpage
TitleBlock One Title=False
Title_Block_Border=False
Title_Block=False
Show Nodes=False
Show Voltages=False
Show Current=False
Show Power=False
Show Condition=False
Show Pin Connections=False
Show Cross=False
Show Attribute Text=True
Show Grid Text=True

[Comp]
Name=k544ca3
Grid=63,39

[Attr]
ONV=0,0,PART,X1
Style=8192

[Attr]
ONV=0,12,NAME,k544ca3

[Comp]
Name=Diode
Grid=47,41
Rot=1

[Attr]
ONV=-31,-22,PART,D1
Style=8192

[Attr]
ONV=-55,-34,MODEL,1N4007

[Attr]
ONV=-51,-58,PACKAGE,DO-41

[Comp]
Name=Diode
Grid=47,49
Rot=1

[Attr]
ONV=-31,-22,PART,D2
Style=8192

[Attr]
ONV=-55,-34,MODEL,1N4007

[Attr]
ONV=-51,-58,PACKAGE,DO-41

[Comp]
Name=Resistor
Grid=47,29
Rot=7

[Attr]
ONV=-32,6,PART,R1
Style=8192

[Attr]
ONV=-30,18,RESISTANCE,1k
Style=8192

[Wire]
Grids=47,35,47,38

[Wire]
Grids=47,47,47,49

[Comp]
Name=Resistor
Grid=57,47
Rot=7

[Attr]
ONV=-32,6,PART,R2
Style=8192

[Attr]
ONV=-36,18,RESISTANCE,10k
Style=8192

[Comp]
Name=Resistor
Grid=57,57
Rot=7

[Attr]
ONV=-32,6,PART,R3
Style=8192

[Attr]
ONV=-36,18,RESISTANCE,10k
Style=8192

[Comp]
Name=Diode
Grid=52,59
Rot=1

[Attr]
ONV=-17,-4,PART,D3
Style=8192

[Attr]
ONV=-55,-34,MODEL,1N4007

[Attr]
ONV=-51,-58,PACKAGE,DO-41

[Wire]
Grids=57,53,57,55

[Wire]
Grids=57,55,57,57

[Wire]
Grids=57,63,57,65

[Wire]
Grids=59,44,61,44

[Wire]
Grids=59,44,59,55

[Wire]
Grids=57,55,59,55

[Comp]
Name=Ground
Grid=55,65
Rot=1

[Wire]
Grids=55,65,57,65

[Comp]
Name=Ground
Grid=47,59
Rot=1

[Comp]
Name=Battery
Grid=11,21
Rot=3

[Attr]
ONV=-24,-25,PART,V2
Style=8192

[Attr]
ONV=-16,-37,VALUE,5

[Wire]
Grids=11,21,11,23

[Comp]
Name=Ground
Grid=11,23
Rot=1

[Wire]
Grids=11,11,11,13

[Wire]
Grids=47,55,47,59

[Wire]
Grids=11,13,11,15

[Wire]
Grids=57,44,57,46

[Wire]
Grids=57,46,57,47

[Wire]
Grids=65,32,65,34

[Wire]
Grids=65,34,65,37

[Wire]
Grids=47,26,47,27

[Wire]
Grids=47,27,47,29

[Comp]
Name=Ground
Grid=65,47
Rot=1

[Wire]
Grids=65,45,65,47

[Comp]
Name=Ground
Grid=72,45
Rot=1

[Wire]
Grids=70,44,72,44

[Wire]
Grids=72,44,72,45

[Wire]
Grids=70,41,79,41

[Comp]
Name=Resistor
Grid=79,34
Rot=7

[Attr]
ONV=-32,6,PART,R4
Style=8192

[Attr]
ONV=-36,18,RESISTANCE,510
Style=8192

[Wire]
Grids=79,40,79,41

[Wire]
Grids=79,41,85,41

[Wire]
Grids=79,32,79,34

[Comp]
Name=Sine Source
Grid=34,46
Rot=5

[Attr]
ONV=18,-24,PART,V3
Style=8192

[Attr]
ONV=18,-36,MODEL,50HZ

[Wire]
Grids=34,38,47,38

[Wire]
Grids=34,38,34,40

[Comp]
Name=Ground
Grid=34,48
Rot=1

[Wire]
Grids=34,46,34,48

[Wire]
Grids=52,65,55,65

[Wire]
Grids=47,38,47,41

[Comp]
Name=Capacitor
Grid=57,38
Rot=6

[Attr]
ONV=-30,12,PART,C1
Style=8192

[Attr]
ONV=-42,24,CAPACITANCE,0.47u
Style=8192

[Wire]
Grids=47,38,51,38

[Wire]
Grids=57,38,61,38

[Comp]
Name=BC847
Grid=85,41

[Attr]
ONV=29,-11,PART,Q1
Style=8192

[Attr]
ONV=29,1,MODEL,BC847A

[Attr]
ONV=29,13,POWER,0.25

[Attr]
ONV=29,37,PACKAGE,SOT-23

[Comp]
Name=Resistor
Grid=88,30
Rot=7

[Attr]
ONV=-32,6,PART,R5
Style=8192

[Attr]
ONV=-36,18,RESISTANCE,330
Style=8192

[Wire]
Grids=88,36,88,38

[Comp]
Name=Ground
Grid=88,46
Rot=1

[Wire]
Grids=88,44,88,46

[Wire]
Grids=88,27,88,28

[Wire]
Grids=88,28,88,30

[Comp]
Name=Battery
Grid=16,21
Rot=3

[Attr]
ONV=-24,-25,PART,V4
Style=8192

[Attr]
ONV=-24,-37,VALUE,3.3

[Comp]
Name=Ground
Grid=16,23
Rot=1

[Wire]
Grids=16,21,16,23

[Wire]
Grids=16,12,16,14

[Wire]
Grids=16,14,16,15

[Wire]
Grids=52,55,52,59

[Wire]
Grids=52,55,57,55

[Grid Text]
Text="5v"
Grid=11,13
CBorder=NONE

[Grid Text]
Text="5v"
Grid=57,46
CBorder=NONE

[Grid Text]
Text="5v"
Grid=65,34
CBorder=NONE

[Grid Text]
Text="5v"
Grid=47,27
CBorder=NONE

[Grid Text]
Text="5v"
Grid=79,34
CBorder=NONE

[Grid Text]
Text="3v"
Grid=88,28
CBorder=NONE

[Grid Text]
Text="3v"
Grid=16,14
CBorder=NONE

[Schematic]
CurrentSection 0=0
CurrentSection 1=0
CurrentSection 2=0
CurrentSection 3=0
Splitter.xs=0
Splitter.ys=0
TextQuad=4099
Scale=0.6666666666666666
PrinterScale=1
GridType=Normal
GridUser=10
ShapeGroups="Main","DeMorgan","Main1","Euro","Rus","Polarity","Main11","Main2","Electrolytic"
CalcRMS=False
CalcAVG=False
CalcPeak=False
DisplayMeasure=Last

[Tools]
Pos=Top
PROBE=Yes
SELECT=Yes
COMP=Yes
TEXT=Yes
WIRE=Yes
WIRED=Yes
BUS=Yes
GRAPHIC=Yes
LINE=No
ELLIPSE=No
RECT=No
DIAM=No
ARC=No
PIE=No
LEFTBRK=No
RIGHTBRK=No
BOTHBRK=No
FLAG=Yes
META=No
INFO=Yes
HELP=Yes
LINK=Yes
REGION_ENABLE=Yes
DIGTRC=No
DIGTRC2=No
DIGALL=No
GRIDTEXT=Yes
COMPTEXT=Yes
NODE=Yes
MEASURED=Yes
NODEV=Yes
CURRENT=Yes
POWER=Yes
CONDITIN=Yes
PIN=Yes
CROSS=Yes
GRID=Yes
BORDER=Yes
TITLE=Yes
RUBBER=Yes
PROPERTY=Yes
STEP=Yes
MIRROR=Yes
ROTATE=Yes
FLIPY=Yes
FLIPX=Yes
FINDCOMP=Yes
FIND=Yes
REPEAT=No
MODEL=Yes
CIR2CKT=No
ATTDISP=No
ENABLE=Yes
DISABLE=Yes
TOFRONT=Yes
TOBACK=Yes
SELNEXT=No
PAGEADD=Yes
PAGEDEL=Yes
ZOOMIN=Yes
ZOOMOUT=Yes
GOTOFLAG=Yes
UPLEVEL=Yes
COLOR=Yes
FONT=Yes

[Section]
Index=0
Name="comprator"
Type=Main
Enable=True
CurrentPage 0=0
CurrentPage 1=0
CurrentPage 2=0
CurrentPage 3=0
TabSize 0=425
TabSize 1=425
TabSize 2=425
TabSize 3=425

[Page]
Index=0
Section=0
Print=True
Enable=True
Name=Main
Scale 0=1
Scale 1=1
Scale 2=1
SB 3=0,96
Scale 3=0.6666666666666666
Grid=55,38

[Page]
Index=1
Section=0
Type=Text
Print=False
Enable=True
Name=Text

[Page]
Index=2
Section=0
Type=Text
Print=False
Enable=True
Name=Models
SB 0=27,3

[Page]
Index=3
Section=0
Type=Info
Print=False
Enable=True
Name=Info

[Text Area]
Section=0
Page=1
Font=Height=-15,FStyle=0,Color=#000080,Name=Courier New
Comment Color=#808080
Background Color=#FFFFFF
Len=0


[Text Area]
Section=0
Page=2
Font=Height=-15,FStyle=0,Color=#000080,Name=Courier New
Comment Color=#808080
Background Color=#FFFFFF
Len=126
*** From file C:\MC9\library\UTILITY.LBR
*** 60HZ Sinusoidal Source
.MODEL 60HZ SIN (A=12 F=50)
.MODEL 50HZ SIN (A=12 F=50)

[Transient]
Window Placement=2,3, 0,749, -8,-30, 25,25,1375,551
Font=Height=-15,FStyle=0,Color=#0000FF,Name=Arial
WinBackGround Color=#FFFFFF
Select Color=#FF0000
Select Box Color=#000080
Title=circuit1.cir
AutoTitle=Yes
Grid Color=#808080
Grid Weight=1
Grid Pattern=Dot6
Tracker Foreground=Height=-15,FStyle=0,Color=#000000,Name=Arial
Tracker Background=#FFFF00
Baseline color=#0000FF
Static Grids=False
PlusMark=False
MinorLog25=Off
LabelMinor=Off
OperPoint=True
OperPointOnly=False
AutoScaleRanges=True
DataPoints=False
Token=False
Ruler=False
XAxisGrids=True
YAxisGrids=True
MinorLogGrids=True
BaseLine=False
Graph Background=#FFFFFF
Tracker Intercept=False
Tracker Mouse=True
Tracker Cursor=True
Tracker Cursor BranchInfo=False
Horizontal Cursor=False
Same Y Scales=Yes
Enable X Scaling=True
Enable Y Scaling=True
Keep X Scales The Same=False
Number of Grids X=5
Number of Grids Y=5
Cursor Select Color Primary=#C0C0C0
Cursor Select Color Secondary=#FF0000
Data Point Labels Color Fore=Height=-15,FStyle=0,Color=#000000,Name=Arial
Data Point Labels Color Back=#FFFF00
FFT_NPts="1024"
FFT_IncludeDCHarmonic=False
FFT_AutoScale_Harmonics="10"
PrinterAutoTile=No
PrinterBlackBorder=No
MonMaxShow=3
MonPageWidth=66
MonPlotWidth=21
MonExprXWidth=142
MonExprYWidth=260
MonRangeXWidth=90
MonRangeYWidth=90
AnimateWait=0
AnimateWaitTime=500
Save_For_Future=No
Reduce_Display=1
Reduce_Save=1
Num Out Header Left
Num Out Header Center="$MC\n$user\n$company\n$Analysis of $name"
Num Out Header Right
Num Out Delimiter=32
Num Out Write=True
Num Out Write Main Header=True
Num Out Write Limits=True
Num Out Write Branch Header=True
Num Out Write Models=True
Num Out Write Zero Models=True
Num Out Write Undefined Models=True
Num Out Write Operating Point=True
Num Out Write Values=True
Num Out Write Waveform Header=True
Num Out Low="TMIN"
Num Out High="TMAX"
Num Out Font=Height=-15,FStyle=0,Color=#000080,Name=Courier New

[Tools]
Pos=Top
SELECT=Yes
GRAPHIC=Yes
LINE=No
ELLIPSE=No
RECT=No
DIAM=No
ARC=No
PIE=No
LEFTBRK=No
RIGHTBRK=No
BOTHBRK=No
POLYCLOS=No
SCALE=Yes
CURSOR=Yes
MEASUREH=Yes
MEASUREV=Yes
TAG=Yes
PTAG=Yes
TEXT=Yes
PROPERTY=Yes
START=Yes
STOP=Yes
PAUSE=Yes
DATAPTS=Yes
TOKENS=Yes
RULER=Yes
PLUS=Yes
XAXIS=Yes
YAXIS=Yes
MINORLOG=Yes
LOG25=Yes
BASELINE=Yes
HORIZCUR=Yes
GOTOX=Yes
GOTOY=Yes
GOTOPERF=Yes
GOTOBRNC=Yes
CLEAR_ACCUMULATED=Yes
PDELETE_ALL_PLOTS=Yes
NEXT=Yes
NEXTIN=Yes
PEAK=Yes
VALLEY=Yes
HIGH=Yes
LOW=Yes
INFLECTN=Yes
GHIGH=Yes
GLOW=Yes
BOTTOM=Yes
TOP=Yes
WAVEFORMBUFFER=Yes
AOUTPUT=Yes
PKEY=Yes
ENXSCALE=Yes
ENYSCALE=Yes
ZOOMIN=Yes
ZOOMOUT=Yes
AUTOSCALE=Yes
COLOR=Yes
FONT=Yes
SELNEXT=No

[APage]
Analysis=Transient
Name="Main"

[AC]
Window Placement=2,3, -1,-1, -8,-30, 175,175,1525,701
Font=Height=-15,FStyle=0,Color=#0000FF,Name=Arial
WinBackGround Color=#FFFFFF
Select Color=#FF0000
Select Box Color=#000080
Title
AutoTitle=Yes
Grid Color=#808080
Grid Weight=1
Grid Pattern=Dot6
Tracker Foreground=Height=-15,FStyle=0,Color=#000000,Name=Arial
Tracker Background=#FFFF00
Baseline color=#0000FF
Static Grids=False
PlusMark=False
MinorLog25=Off
LabelMinor=Off
OperPoint=True
OperPointOnly=False
AutoScaleRanges=False
DataPoints=False
Token=False
Ruler=False
XAxisGrids=True
YAxisGrids=True
MinorLogGrids=True
BaseLine=False
Graph Background=#FFFFFF
Tracker Intercept=False
Tracker Mouse=True
Tracker Cursor=True
Tracker Cursor BranchInfo=False
Horizontal Cursor=False
Same Y Scales=Yes
Enable X Scaling=True
Enable Y Scaling=True
Keep X Scales The Same=False
Number of Grids X=5
Number of Grids Y=5
Cursor Select Color Primary=#C0C0C0
Cursor Select Color Secondary=#FF0000
Data Point Labels Color Fore=Height=-15,FStyle=0,Color=#000000,Name=Arial
Data Point Labels Color Back=#FFFF00
FFT_NPts="1024"
FFT_IncludeDCHarmonic=False
FFT_AutoScale_Harmonics="10"
PrinterAutoTile=No
PrinterBlackBorder=No
MonMaxShow=3
MonPageWidth=66
MonPlotWidth=21
MonExprXWidth=142
MonExprYWidth=260
MonRangeXWidth=90
MonRangeYWidth=90
AnimateWait=0
AnimateWaitTime=500
Save_For_Future=No
Reduce_Display=1
Reduce_Save=1
Num Out Header Left
Num Out Header Center="$MC\n$user\n$company\n$Analysis of $name"
Num Out Header Right
Num Out Delimiter=32
Num Out Write=True
Num Out Write Main Header=True
Num Out Write Limits=True
Num Out Write Branch Header=True
Num Out Write Models=True
Num Out Write Zero Models=True
Num Out Write Undefined Models=True
Num Out Write Operating Point=True
Num Out Write Noise=True
Num Out Write Values=True
Num Out Write Waveform Header=True
Num Out Low="FMIN"
Num Out High="FMAX"
Num Out Font=Height=-15,FStyle=0,Color=#000080,Name=Courier New

[Tools]
Pos=Top
SELECT=Yes
GRAPHIC=Yes
LINE=No
ELLIPSE=No
RECT=No
DIAM=No
ARC=No
PIE=No
LEFTBRK=No
RIGHTBRK=No
BOTHBRK=No
POLYCLOS=No
SCALE=Yes
CURSOR=Yes
MEASUREH=Yes
MEASUREV=Yes
TAG=Yes
PTAG=Yes
TEXT=Yes
PROPERTY=Yes
START=Yes
STOP=Yes
PAUSE=Yes
DATAPTS=Yes
TOKENS=Yes
RULER=Yes
PLUS=Yes
XAXIS=Yes
YAXIS=Yes
MINORLOG=Yes
LOG25=Yes
BASELINE=Yes
HORIZCUR=Yes
GOTOX=Yes
GOTOY=Yes
GOTOPERF=Yes
GOTOBRNC=Yes
CLEAR_ACCUMULATED=Yes
PDELETE_ALL_PLOTS=Yes
NEXT=Yes
NEXTIN=Yes
PEAK=Yes
VALLEY=Yes
HIGH=Yes
LOW=Yes
INFLECTN=Yes
GHIGH=Yes
GLOW=Yes
BOTTOM=Yes
TOP=Yes
WAVEFORMBUFFER=Yes
AOUTPUT=Yes
PKEY=Yes
ENXSCALE=Yes
ENYSCALE=Yes
ZOOMIN=Yes
ZOOMOUT=Yes
AUTOSCALE=Yes
COLOR=Yes
FONT=Yes
SELNEXT=No

[APage]
Analysis=AC
Name="Main"

[Monte Carlo Options]
Analysis=Transient
Status=Off
Zero Tolerance=False
Distribution=Normal
Number of Runs=10
Seed=0

[Monte Carlo Options]
Analysis=AC
Status=Off
Zero Tolerance=False
Distribution=Normal
Number of Runs=10
Seed=0

[Limits]
Analysis=Transient
TRange=500m
TStep=0.001
NPts=51
Temp=27
RetraceRuns=1
StateVar=Zero
RunOption=Normal
Temperature Type=Linear
Accumulate Plots=False

[WaveForm]
Analysis=Transient
Plt=1
AliasID=1
XExp=T
YExp=v(1)
XRng=0.5
YRng=16,-4
Options=LINEARX,LINEARY
Range Grid X=0.1
Range Grid Y=4
Line Color=#0000FF
Text Color=#0000FF
Rainbow=False
VFmtX=3
VFmtY=3
ScaleFactorX="None"
ScaleFactorY="None"
ScaleUnitsX="Auto"
ScaleUnitsY="Auto"
SFmtX=3
SFmtY=3

[WaveForm]
Analysis=Transient
Plt=1
AliasID=2
XExp=T
YExp=v(4)
XRng=0.5
YRng=16,-4
Options=LINEARX,LINEARY
Range Grid X=0.1
Range Grid Y=4
Line Color=#FF0000
Text Color=#FF0000
Rainbow=False
VFmtX=3
VFmtY=3
ScaleFactorX="None"
ScaleFactorY="None"
ScaleUnitsX="Auto"
ScaleUnitsY="Auto"
SFmtX=3
SFmtY=3

[WaveForm]
Analysis=Transient
Plt=1
AliasID=3
XExp=T
YExp=v(7)
XRng=0.5
YRng=16,-4
Options=LINEARX,LINEARY
Range Grid X=0.1
Range Grid Y=4
Line Color=#008000
Text Color=#008000
Rainbow=False
VFmtX=3
VFmtY=3
ScaleFactorX="None"
ScaleFactorY="None"
ScaleUnitsX="Auto"
ScaleUnitsY="Auto"
SFmtX=3
SFmtY=3

[Limits]
Analysis=AC
FRange=1E8,1Meg
NPts=51
Temp=27
MaxChng=5
NInput=NONE
NOutput=2
Sweep type=Auto
StateVar=Zero
RunOption=Normal
Temperature Type=Linear
Accumulate Plots=False

[WaveForm]
Analysis=AC
Plt=1
AliasID=1
XExp=F
YExp=db(v(1))
XRng=1e8,1e6
YRng=-8.56e-6,-8.96e-6
Options=LINEARY
Range Grid X=1.98e7
Range Grid Y=8e-8
Line Color=#0000FF
Text Color=#0000FF
Rainbow=False
VFmtX=3
VFmtY=3
ScaleFactorX="None"
ScaleFactorY="None"
ScaleUnitsX="Auto"
ScaleUnitsY="Auto"
SFmtX=3
SFmtY=3

[WaveForm]
Analysis=AC
Plt=2
AliasID=2
XExp=F
YExp=ph(v(1))
XRng=1e8,1e6
YRng=0.00016,-0.00064
Options=LINEARY
Range Grid X=1.98e7
Range Grid Y=0.00016
Line Color=#FF0000
Text Color=#FF0000
Rainbow=False
VFmtX=3
VFmtY=3
ScaleFactorX="None"
ScaleFactorY="None"
ScaleUnitsX="Auto"
ScaleUnitsY="Auto"
SFmtX=3
SFmtY=3

[WaveForm]
Analysis=AC
AliasID=-1
Options=LINEARY
Line Color=#008000
Text Color=#008000
Rainbow=False
VFmtX=3
VFmtY=3
ScaleFactorX="None"
ScaleFactorY="None"
ScaleUnitsX="Auto"
ScaleUnitsY="Auto"
SFmtX=3
SFmtY=3

[Limits]
Analysis=DynamicAC
FirstValueDisplay=Mag
SecondValueDisplay=PhaseDeg
PlaceText=True

[Limits]
Analysis=DynamicDC
PlaceText=True

[Pane]
Analysis=Transient
CurrentPage 0="Main"

[Pane]
Analysis=AC
CurrentPage 0="Main"

[Pane]
Analysis=DC

[Pane]
Analysis=Distortion

[Watch]
Analysis=Transient
Format=3
ExprPercentWidth=80

[Watch]
Analysis=AC
Format=3
ExprPercentWidth=80

[TF]
Input Source=V3
Place Text=True

[OPMethods]
Analysis=Transient
Standard Newton-Raphson=0,0
Source Stepping=0,0
Diagonal Gmin Stepping=0,0
Junction Gmin Stepping=0,0
Pseudo Transient=0,0

[OPMethods]
Analysis=AC
Standard Newton-Raphson=0,0
Source Stepping=0,0
Diagonal Gmin Stepping=0,0
Junction Gmin Stepping=0,0
Pseudo Transient=0,0

[OPMethods]
Analysis=DC
Standard Newton-Raphson=0,0
Source Stepping=0,0
Diagonal Gmin Stepping=0,0
Junction Gmin Stepping=0,0
Pseudo Transient=0,0
