milssky/diploma/(list of files, drawings)

Other design files:
scheme.pcb
Моделирование/current_meter.ms12
Моделирование/power_out.ms12
Моделирование/zero-cross_detector.ms12
