milssky/diploma/(commit log)

2013-02-17 Первый коммит
2013-02-19 Ддобавлен раздел по преддипломной практике
2013-03-02 Задание на диплом
2013-03-11 Добавлена библиотека компонентов
2013-03-11 Узел синхронизации на схеме. Исправлена библиотека
    [scheme.sch]
2013-03-11 Добавлен лист 1 - Структурная схема
2013-03-12 Отчет по практике готов
    [Перечень.xls]
2013-03-12 Чистка
2013-03-20 Готова почти вся схема за исключением входной цепи для датчика тока
    [scheme.sch]
2013-03-21 Схема завершена
    [scheme.sch]
2013-03-21 Переименование элементов по ГОСТ
    [scheme.sch]
2013-03-23 Исправлен косяк на VBAT
    [scheme.sch]
2013-03-23 Рассчитана и исправлена входная цепь для датчика тока. Добавлена защита на вход разрешения сварки.
    [scheme.sch]
2013-03-23 УГО разъмов в едином стиле. Размер шрифтов един для всего.
    [scheme.sch]
2013-03-23 Все УГО по ГОСТ.
    [scheme.sch]
2013-03-25 Добавлен лист со схемой и моделирование аналоговых узлов
    [scheme.sch]
2013-03-25 Добавлены плата и моделирование силовой части. Исправлен .gitignore для исключения файлов с ошибками.
    [scheme.pcb]
2013-03-26 Расставлены элементы на плате.
    [scheme.pcb]
2013-03-26 Разведена плата
    [scheme.pcb]
2013-03-26 Исправлена структурка. Добавлен расчет ОУ в цепи датчика тока.
2013-03-27 Гербер файлы
    [scheme.pcb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]
2013-03-29 Устранены КЗ на плате, увеличены размеры пятаков, переходных отверстий и ширина большинства проводников
    [scheme.pcb]
2013-03-29 Добавлены заготовки для 3,4,5 листов.
2013-03-29 Лист 3 - Чертеж платы готов. Мелкий фикс разводки.
    [scheme.pcb]
2013-03-31 Косметика на схеме и чертеже платы. Начата сборка и добавлена спецификация под нее.
2013-03-31 Фикс схемы. Закончена спецификация на сборку платы.
    [scheme.sch]
2013-03-31 Фикс документации в спецификации.
2013-03-31 Сборка готова. Очередной фикс спецификации.
2013-03-31 Добавлен алгоритм. Косметика на сборке платы.
2013-03-31 Добавлена глава по БЖД
2013-04-16 Добавлен чертеж трафарета. Пофикшены ошибки
    [scheme.sch]
2013-04-19 Много 3д и фикс трафарета
2013-04-20 Много компонентов в 3д для сборки платы
2013-04-22 Закончена сборка в 3д
2013-04-28 Добавлен чертеж общего вида
2013-05-03 Временнные диаграммы
2013-05-08 Сборка блока со спецификацией
2013-05-09 Деталировка №1: передняя и задняя панель
2013-05-11 Дочерчена деталировка
2013-05-12 Добавлены моделирование и ТП
    [current_meter.ms12, power_out.ms12, time.csv, zero-cross_detector.ms12]
2013-05-12 Экономика и фиксы найденных багов.
2013-05-14 Фикс экономической части
2013-05-16 Фиксы листов. Графическая часть готова.
2013-05-31 Подписаны все чертежи, косметика
2013-05-31 Принципиальная фикс
2013-05-31 Техпроцесс
2013-06-01 Косметика
2013-06-01 Добавлены заготовки расчетов
2013-06-01 Расчет на воздествие вибраций
2013-06-01 Тепловой расчет
2013-06-01 Расчет надежности, наработки на отказ и времени восстановления
2013-06-01 Расчет трафарета и количества паяльной пасты
2013-06-02 Введение, аннотация, исследовательская части записки
    [current_meter.ms12, power_out.ms12, zero-cross_detector.ms12]
2013-06-02 Вся писанина из конструкторской части
2013-06-02 Записка готова
2013-06-03 Перечень элементов и пдфки
2013-06-04 Рецензия
2013-06-04 Фикс деталировки. Неуказанная шероховатость и ТТ
2013-06-10 Презентация и речь
2013-06-12 Фиксы презентации и речи
2013-06-15 Правка речи и презентации
2013-06-15 Фикс речи и презентации. Добавлены слайды с деталировкой и расчетами.
